bradAnders/kicad_PLEC/README.md

# kicad_PLEC
KiCad project for OSU USLI 2018 Payload Ejection Controller
