bradAnders/kicad_PLEC/PLEC_digikey_order1.xlsx

# | Quantity | Part Number | Manufacturer Part Number | Description | Customer Reference | Backorder | Unit Price | Extended Price
1 | 1 | 1568-1465-ND | DEV-14058 | TEENSY 3.6 (HEADERS) |  | 0 | 36.88 | 36.88
2 | 1 | 602-1346-ND | XBP9B-DMSTB002 | RF TXRX MODULE ISM<1GHZ RP-SMA |  | 0 | 42.76 | 42.76
3 | 1 | LM1085IT-5.0/NOPB-ND | LM1085IT-5.0/NOPB | IC REG LINEAR 5V 3A TO220-3 |  | 0 | 1.92 | 1.92
4 | 1 | LM1085IT-3.3/NOPB-ND | LM1085IT-3.3/NOPB | IC REG LINEAR 3.3V 3A TO220-3 |  | 0 | 1.92 | 1.92
5 | 1 | TLP222AF-ND | TLP222AF | PHOTOCOUPLER PHOTORELAY 4-DIP |  | 0 | 1.08 | 1.08
6 | 2 | TLP222A-2F-ND | TLP222A-2(F) | PHOTOCOUPLER PHOTORELAY 8-DIP |  | 0 | 2.16 | 4.32
7 | 5 | PB1167-ND | 1-1462039-5 | RELAY TELECOM DPDT 2A 3V |  | 0 | 4.43 | 22.15
8 | 1 | 398-1025-5-ND | HXS 20-NP | SENSOR CURRENT HALL 5A, 10A, 20A |  | 0 | 16.42 | 16.42
9 | 10 | 478-5094-ND | AR205F102K4R | CAP CER 1000PF 50V X8R RADIAL |  | 0 | 0.49 | 4.90
10 | 10 | 493-14716-ND | UEP1J4R7MED | CAP ALUM 4.7UF 20% 63V THRU HOLE |  | 0 | 0.455 | 4.55
11 | 10 | 493-14987-ND | UEP1J100MED | CAP ALUM 10UF 20% 63V RADIAL |  | 0 | 0.507 | 5.07
12 | 10 | CPF100KBCT-ND | CPF1100K00FEEE6 | RESISTOR METAL FILM 1W 100K OHM |  | 0 | 0.655 | 6.55
13 | 4 | CPF402BCT-ND | CPF1402R00FEEE6 | RESISTOR METAL FILM 1W 402 OHM |  | 0 | 0.79 | 3.16
14 | 2 | KSC2073H2TU-ND | KSC2073H2TU | TRANS NPN 150V 1.5A TO-220 |  | 0 | 0.64 | 1.28
15 | 4 | 754-1717-ND | WP424SRDT | LED RED DIFF 3MM ROUND T/H |  | 0 | 0.44 | 1.76
16 | 1 | CKN11096-ND | A102S1RNZQ | SWITCH ROTARY 2POS 2.5A 125V |  | 0 | 4.26 | 4.26
17 | 1 | J490-ND | 142-0701-401 | CONN SMA JACK STR 50 OHM SOLDER |  | 0 | 5.78 | 5.78
18 | 1 | CBA-SMA-SMA18-ND | CBA-SMA-SMA18 | CBL ASSY SMA M-SMA M REV 1800MM |  | 0 | 12.22 | 12.22
19 | 1 | ED10561-ND | OSTVN02A150 | CONN TERM BLOCK 2.54MM 2POS PCB |  | 0 | 0.91 | 0.91
20 | 1 | ED10562-ND | OSTVN03A150 | CONN TERM BLOCK 2.54MM 3POS PCB |  | 0 | 1.03 | 1.03
21 | 1 | ED10563-ND | OSTVN04A150 | CONN TERM BLOCK 2.54MM 4POS PCB |  | 0 | 1.38 | 1.38
22 | 1 | ED10565-ND | OSTVN06A150 | CONN TERM BLOCK 2.54MM 6POS PCB |  | 0 | 1.77 | 1.77
23 | 3 | WM18900-ND | 22-05-7025 | CONN HEADER 2POS 2.5MM R/A TIN |  | 0 | 0.59 | 1.77
24 | 3 | WM18873-ND | 0050375023 | CONN HOUSING 2POS 2.5MM SHROUD |  | 0 | 0.21 | 0.63
25 | 2 | 1N5619GP-E3/54GICT-ND | 1N5619GP-E3/54 | DIODE GEN PURP 600V 1A DO204AC |  | 0 | 0.41 | 0.82
