bradAnders/kicad_PLEC/PLEC.sch

## KiCad design PLEC.sch (2018-02-16)

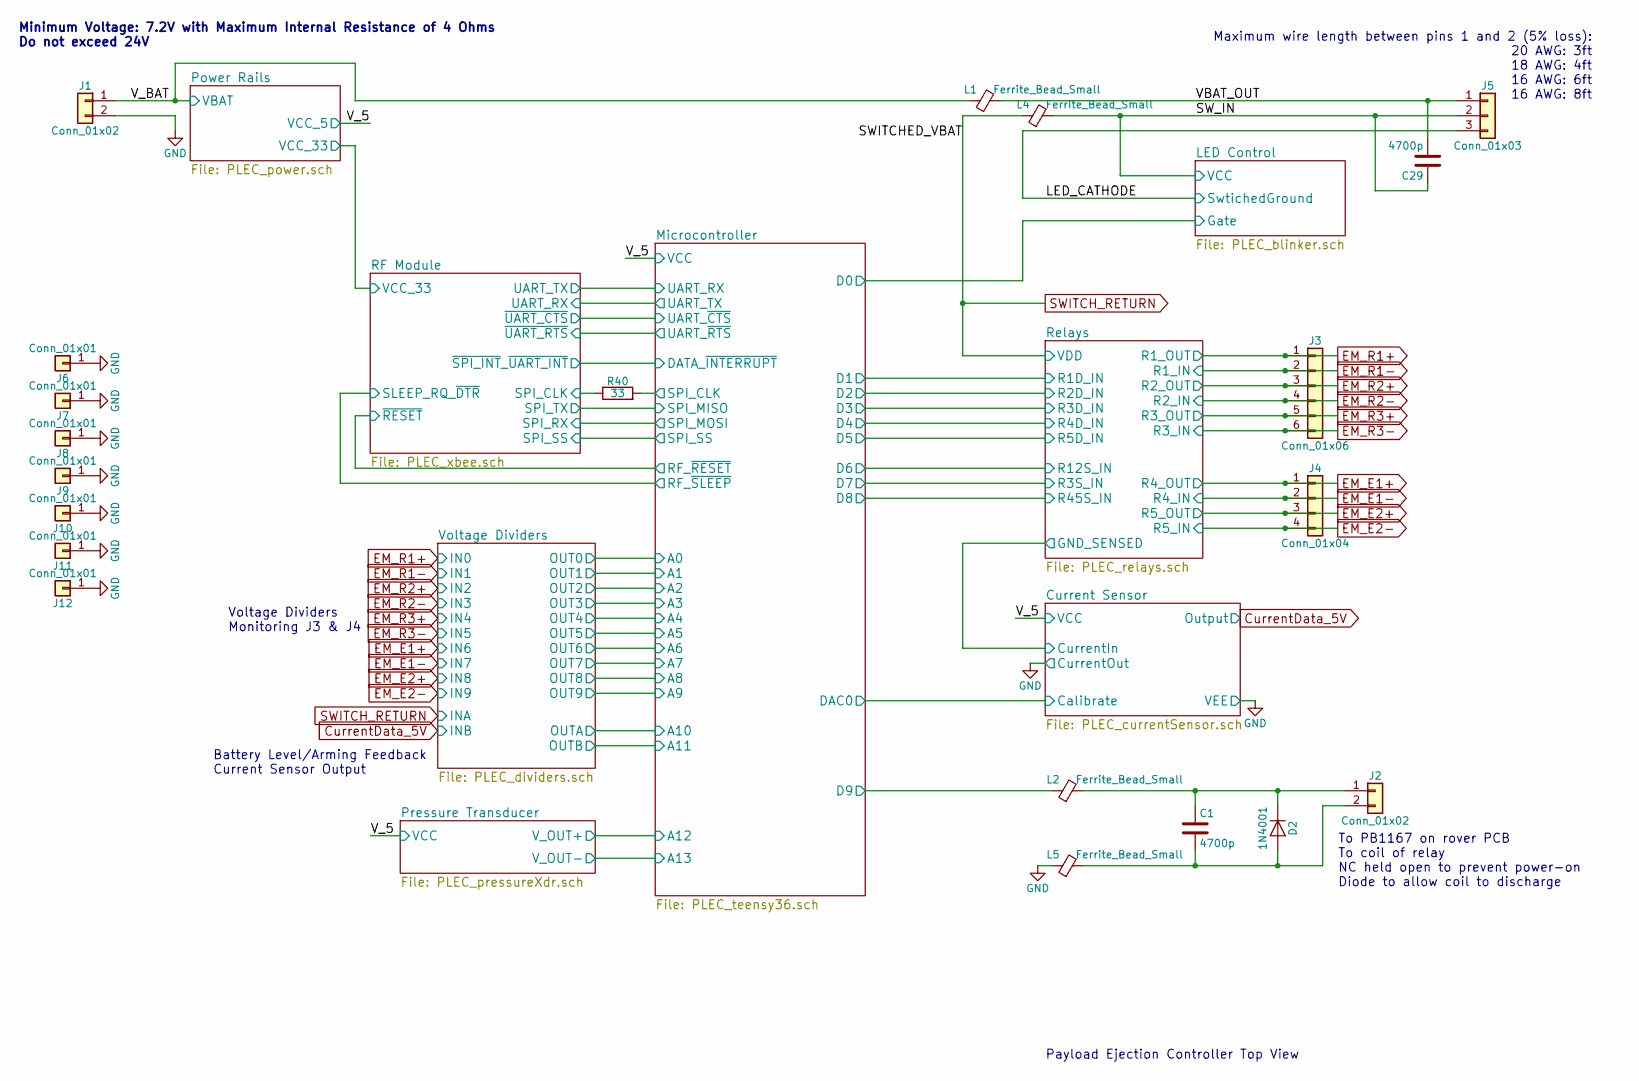
[picture p1: schematic PLEC.sch]

Parts:
C1, C29: 4700p; THTt_100Px150Lx100Wx183H_4700p
D2: 1N4001; D_DO-41_SOD81_P2.54mm_Vertical_KathodeUp
J1: Conn_01x02; TerminalBlock_Altech_AK300-2_P5.00mm
J2: Conn_01x02; THT_TerminalBlock_2.5mm_2pos
J3: Conn_01x06; THT_TerminalBlock_2.5mm_6pos
J4: Conn_01x04; THT_TerminalBlock_2.5mm_4pos
J5: Conn_01x03; THT_TerminalBlock_2.5mm_3pos
J6, J7, J8, J9, J10, J11: Conn_01x01; Hole4-40
J12: Conn_01x01; Via-0.6mm
L1, L2, L4, L5: Ferrite_Bead_Small; L_Axial_L7.0mm_D3.3mm_P5.08mm_Vertical_Fastron_MICC
R40: 33; R_Axial_DIN0204_L3.6mm_D1.6mm_P5.08mm_Horizontal

Connections:
D9: L2.1
EM_E1+: J4.1
EM_E1-: J4.2
EM_E2+: J4.3
EM_E2-: J4.4
EM_R1+: J3.1
EM_R1-: J3.2
EM_R2+: J3.3
EM_R2-: J3.4
EM_R3+: J3.5
EM_R3-: J3.6
GND: J1.2, J6.1, J7.1, J8.1, J9.1, J10.1, J11.1, J12.1, L5.1
LED_CATHODE: J5.3
unnamed: C1.1, D2.1 (K), J2.1, L2.2
unnamed: C1.2, D2.2 (A), J2.2, L5.2
SPI_CLK: R40.1, R40.2
SWITCH_RETURN: L4.1
SW_IN: C29.1, J5.2, L4.2
VBAT_OUT: C29.2, J5.1, L1.2
V_BAT: J1.1, L1.1

Notes on the sheet:
Payload Ejection Controller Top View
Minimum Voltage: 7.2V with Maximum Internal Resistance of 4 Ohms Do not exceed 24V
Maximum wire length between pins 1 and 2 (5% loss): 20 AWG: 3ft 18 AWG: 4ft 16 AWG: 6ft 16 AWG: 8ft
Voltage Dividers Monitoring J3 & J4
Battery Level/Arming Feedback Current Sensor Output
To PB1167 on rover PCB To coil of relay NC held open to prevent power-on Diode to allow coil to discharge
