bradAnders/kicad_PLEC/PLEC_blinker.sch

## KiCad design PLEC_blinker.sch (2018-02-16)

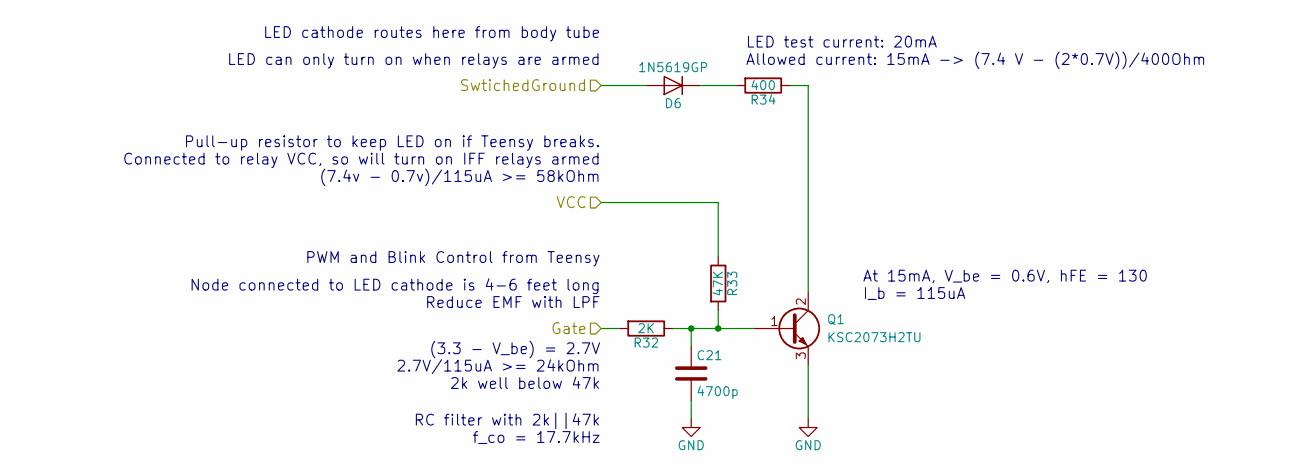
[picture p2: schematic PLEC_blinker.sch]

Parts:
C21: 4700p; THTt_100Px150Lx100Wx183H_4700p
D6: 1N5619GP; D_DO-41_SOD81_P2.54mm_Vertical_KathodeUp
Q1: KSC2073H2TU; TO-220-3_Vertical
R32: 2K; R_Axial_DIN0204_L3.6mm_D1.6mm_P5.08mm_Horizontal
R33: 47K; R_Axial_DIN0204_L3.6mm_D1.6mm_P5.08mm_Horizontal
R34: 400; R_Axial_DIN0207_L6.3mm_D2.5mm_P10.16mm_Horizontal

Connections:
GND: C21.2, Q1.3 (E)
Gate: R32.2
unnamed: C21.1, Q1.1 (B), R32.1, R33.2
unnamed: D6.1 (K), R34.2
unnamed: Q1.2 (C), R34.1
SwtichedGround: D6.2 (A)
VCC: R33.1

Notes on the sheet:
LED can only turn on when relays are armed
PWM and Blink Control from Teensy
Node connected to LED cathode is 4-6 feet long Reduce EMF with LPF
LED cathode routes here from body tube
Pull-up resistor to keep LED on if Teensy breaks. Connected to relay VCC, so will turn on IFF relays armed (7.4v - 0.7v)/115uA >= 58kOhm
LED test current: 20mA Allowed current: 15mA -> (7.4 V - (2*0.7V))/400Ohm
At 15mA, V_be = 0.6V, hFE = 130 I_b = 115uA
(3.3 - V_be) = 2.7V 2.7V/115uA >= 24kOhm 2k well below 47k
RC filter with 2k||47k f_co = 17.7kHz
