bradAnders/kicad_PLEC/PLEC_currentSensor.sch

## KiCad design PLEC_currentSensor.sch (2018-02-14)

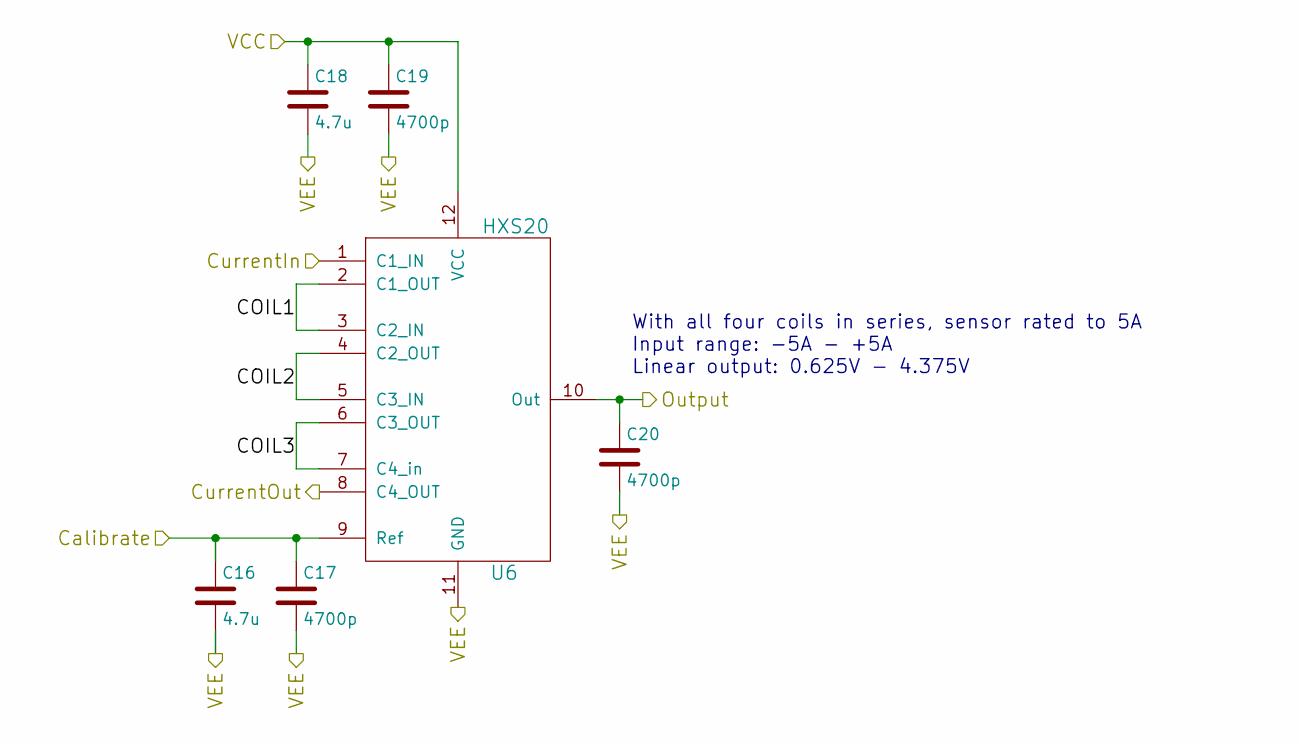
[picture p3: schematic PLEC_currentSensor.sch]

Parts:
C16, C18: 4.7u; THTm_1.5Px4Dx7H_4.7u
C17, C19, C20: 4700p; THTt_100Px150Lx100Wx183H_4700p
U6: HXS20

Connections:
COIL1: U6.2 (C1_OUT), U6.3 (C2_IN)
COIL2: U6.4 (C2_OUT), U6.5 (C3_IN)
COIL3: U6.6 (C3_OUT), U6.7 (C4_in)
Calibrate: C16.1, C17.1, U6.9 (Ref)
CurrentIn: U6.1 (C1_IN)
CurrentOut: U6.8 (C4_OUT)
Output: C20.1, U6.10 (Out)
VCC: C18.1, C19.1, U6.12 (VCC)
VEE: C16.2, C17.2, C18.2, C19.2, C20.2, U6.11 (GND)

Notes on the sheet:
With all four coils in series, sensor rated to 5A Input range: -5A - +5A Linear output: 0.625V - 4.375V
