bradAnders/kicad_PLEC/PLEC_dividers.sch

## KiCad design PLEC_dividers.sch (2018-02-16)

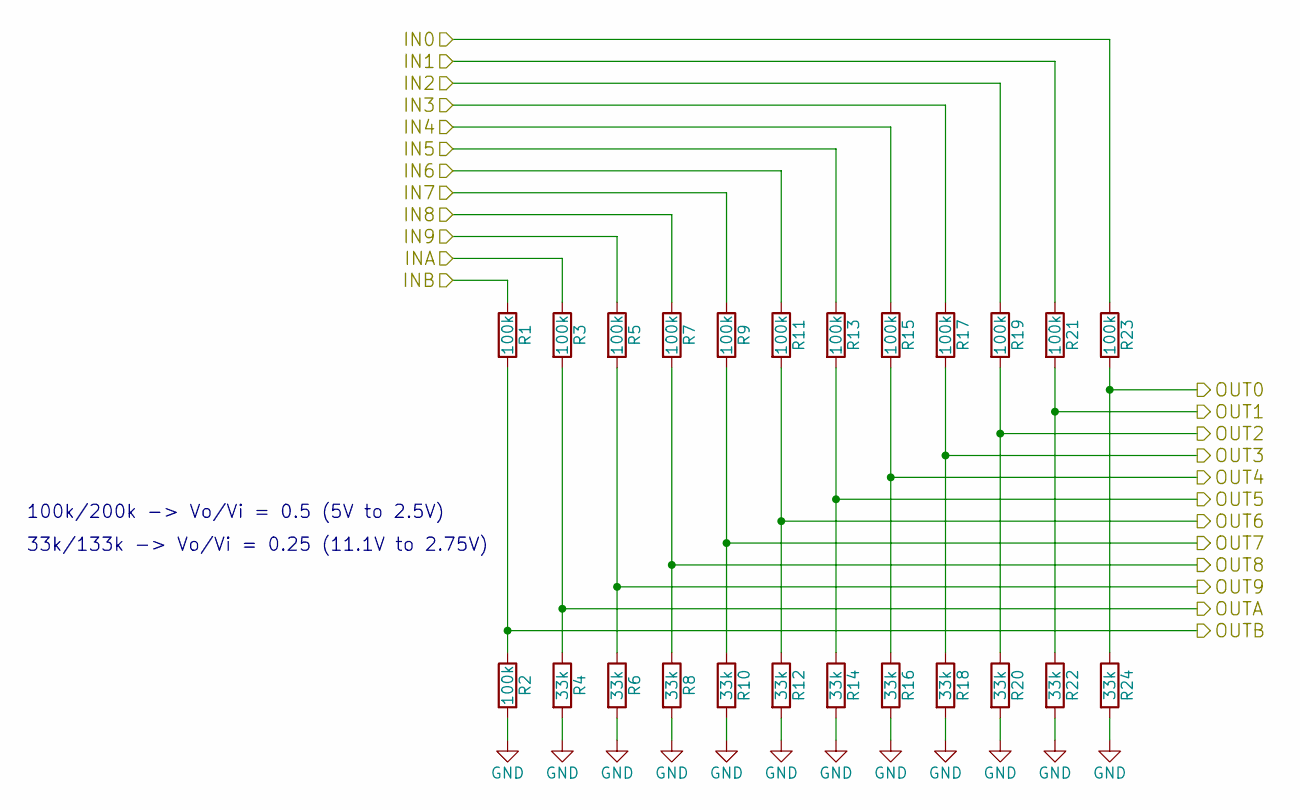
[picture p4: schematic PLEC_dividers.sch]

Parts:
R1, R2, R3, R5, R7, R9, R11, R13, R15, R17, R19, R21, R23: 100k; R_Axial_DIN0204_L3.6mm_D1.6mm_P5.08mm_Horizontal
R4, R6, R8, R10, R12, R14, R16, R18, R20, R22, R24: 33k; R_Axial_DIN0204_L3.6mm_D1.6mm_P5.08mm_Horizontal

Connections:
GND: R2.2, R4.2, R6.2, R8.2, R10.2, R12.2, R14.2, R16.2, R18.2, R20.2, R22.2, R24.2
IN0: R23.1
IN1: R21.1
IN2: R19.1
IN3: R17.1
IN4: R15.1
IN5: R13.1
IN6: R11.1
IN7: R9.1
IN8: R7.1
IN9: R5.1
INA: R3.1
INB: R1.1
OUT0: R23.2, R24.1
OUT1: R21.2, R22.1
OUT2: R19.2, R20.1
OUT3: R17.2, R18.1
OUT4: R15.2, R16.1
OUT5: R13.2, R14.1
OUT6: R11.2, R12.1
OUT7: R9.2, R10.1
OUT8: R7.2, R8.1
OUT9: R5.2, R6.1
OUTA: R3.2, R4.1
OUTB: R1.2, R2.1

Notes on the sheet:
100k/200k -> Vo/Vi = 0.5 (5V to 2.5V)
33k/133k -> Vo/Vi = 0.25 (11.1V to 2.75V)
