bradAnders/kicad_PLEC/PLEC_power.sch

## KiCad design PLEC_power.sch (2018-02-16)

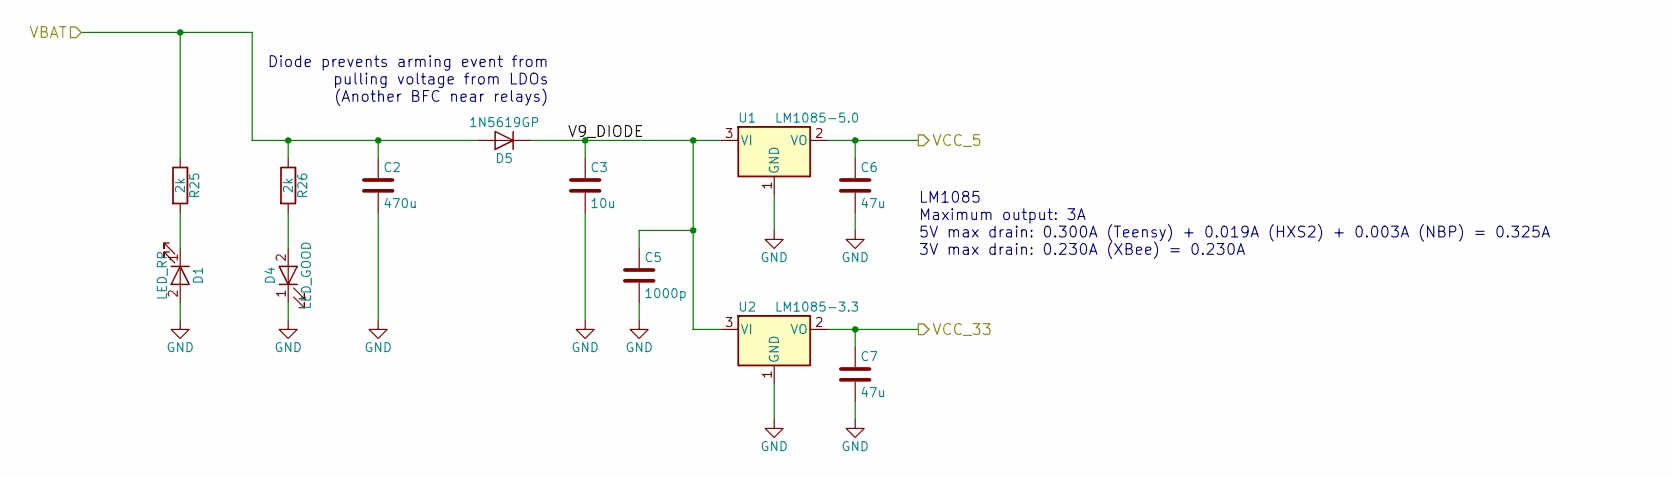
[picture p5: schematic PLEC_power.sch]

Parts:
C2: 470u; THTm_5Px8Dx22H__470u
C3: 10u; THTm_1.5Px4Dx7H_10u
C5: 1000p; THTt_100Px200Lx125Wx200H_1000p
C6, C7: 47u; THTm_2Px4Dx12H_47u
D1: LED_RP; LED_D3.0mm_FlatTop
D4: LED_GOOD; LED_D5.0mm_FlatTop
D5: 1N5619GP; D_DO-15_P10.16mm_Horizontal
R25, R26: 2k; R_Axial_DIN0204_L3.6mm_D1.6mm_P5.08mm_Horizontal
U1: LM1085-5.0; TO-220-3_Vertical
U2: LM1085-3.3; TO-220-3_Vertical

Connections:
GND: C2.2, C3.2, C5.2, C6.2, C7.2, D1.2 (A), D4.1 (K), U1.1 (GND), U2.1 (GND)
unnamed: D1.1 (K), R25.2
unnamed: D4.2 (A), R26.2
V9_DIODE: C3.1, C5.1, D5.1 (K), U1.3 (VI), U2.3 (VI)
VBAT: C2.1, D5.2 (A), R25.1, R26.1
VCC_5: C6.1, U1.2 (VO)
VCC_33: C7.1, U2.2 (VO)

Notes on the sheet:
Diode prevents arming event from pulling voltage from LDOs (Another BFC near relays)
LM1085 Maximum output: 3A 5V max drain: 0.300A (Teensy) + 0.019A (HXS2) + 0.003A (NBP) = 0.325A 3V max drain: 0.230A (XBee) = 0.230A
