bradAnders/kicad_PLEC/PLEC_pressureXdr.sch

## KiCad design PLEC_pressureXdr.sch (2018-02-16)

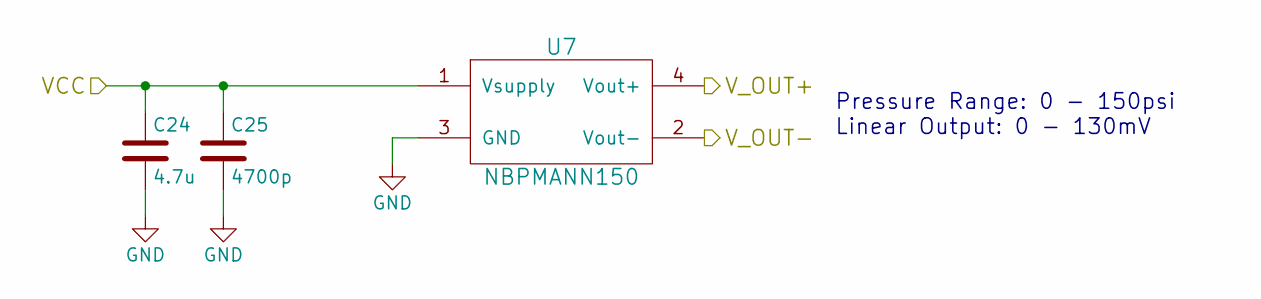
[picture p6: schematic PLEC_pressureXdr.sch]

Parts:
C24: 4.7u; THTm_1.5Px4Dx7H_4.7u
C25: 4700p; THTt_100Px150Lx100Wx183H_4700p
U7: NBPMANN150; NBPMANN

Connections:
GND: C24.2, C25.2, U7.3 (GND)
VCC: C24.1, C25.1, U7.1 (Vsupply)
V_OUT+: U7.4 (Vout+)
V_OUT-: U7.2 (Vout-)

Notes on the sheet:
Pressure Range: 0 - 150psi Linear Output: 0 - 130mV
