bradAnders/kicad_PLEC/PLEC_relays.sch

## KiCad design PLEC_relays.sch (2018-02-16)

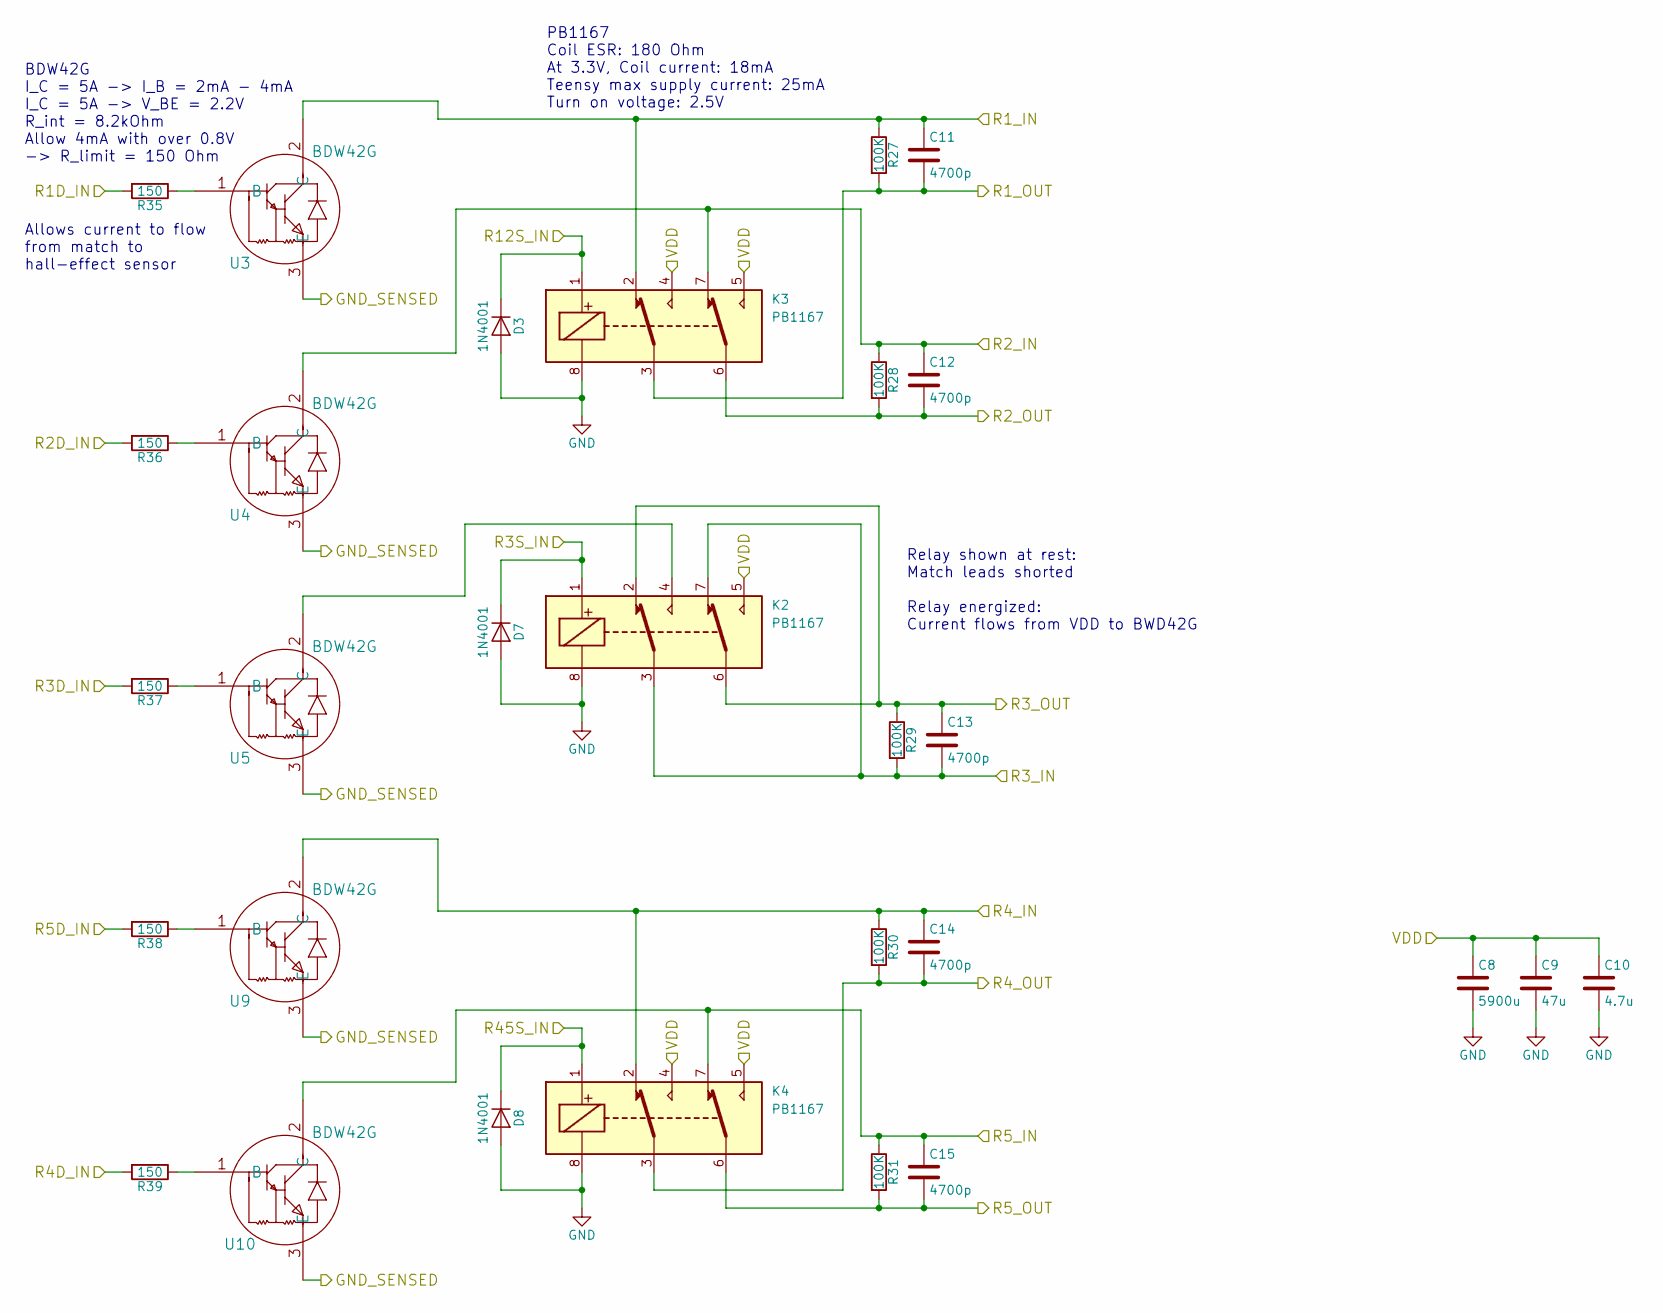
[picture p7: schematic PLEC_relays.sch]

Parts:
C8: 5900u; ELBK250
C9: 47u; THTm_2Px4Dx12H_47u
C10: 4.7u; THTm_1.5Px4Dx7H_4.7u
C11, C12, C13, C14, C15: 4700p; THTt_100Px150Lx100Wx183H_4700p
D3, D7, D8: 1N4001; D_DO-41_SOD81_P2.54mm_Vertical_KathodeUp
K2, K3, K4: PB1167
R27, R28, R29, R30, R31: 100K; R_Axial_DIN0204_L3.6mm_D1.6mm_P5.08mm_Horizontal
R35, R36, R37, R38, R39: 150; R_Axial_DIN0204_L3.6mm_D1.6mm_P5.08mm_Horizontal
U3, U4, U5, U9, U10: BDW42G

Connections:
GND: C8.2, C9.2, C10.2, D3.2 (A), D7.2 (A), D8.2 (A), K2.8, K3.8, K4.8
GND_SENSED: U3.3 (E), U4.3 (E), U5.3 (E), U9.3 (E), U10.3 (E)
unnamed: K2.4, U5.2 (C)
unnamed: R35.1, U3.1 (B)
unnamed: R36.1, U4.1 (B)
unnamed: R37.1, U5.1 (B)
unnamed: R38.1, U9.1 (B)
unnamed: R39.1, U10.1 (B)
R1D_IN: R35.2
R1_IN: C11.1, K3.2, R27.1, U3.2 (C)
R1_OUT: C11.2, K3.3, R27.2
R2D_IN: R36.2
R2_IN: C12.1, K3.7, R28.1, U4.2 (C)
R2_OUT: C12.2, K3.6, R28.2
R3D_IN: R37.2
R3S_IN: D7.1 (K), K2.1
R3_IN: C13.2, K2.3, K2.7, R29.2
R3_OUT: C13.1, K2.2, K2.6, R29.1
R4D_IN: R39.2
R4_IN: C14.1, K4.2, R30.1, U9.2 (C)
R4_OUT: C14.2, K4.3, R30.2
R5D_IN: R38.2
R5_IN: C15.1, K4.7, R31.1, U10.2 (C)
R5_OUT: C15.2, K4.6, R31.2
R12S_IN: D3.1 (K), K3.1
R45S_IN: D8.1 (K), K4.1
VDD: C8.1, C9.1, C10.1, K2.5, K3.4, K3.5, K4.4, K4.5

Notes on the sheet:
PB1167 Coil ESR: 180 Ohm At 3.3V, Coil current: 18mA Teensy max supply current: 25mA Turn on voltage: 2.5V
BDW42G I_C = 5A -> I_B = 2mA - 4mA I_C = 5A -> V_BE = 2.2V R_int = 8.2kOhm Allow 4mA with over 0.8V -> R_limit = 150 Ohm
Relay shown at rest: Match leads shorted Relay energized: Current flows from VDD to BWD42G
Allows current to flow from match to hall-effect sensor
