bradAnders/kicad_PLEC/PLEC_teensy36.sch

## KiCad design PLEC_teensy36.sch (2018-02-16)

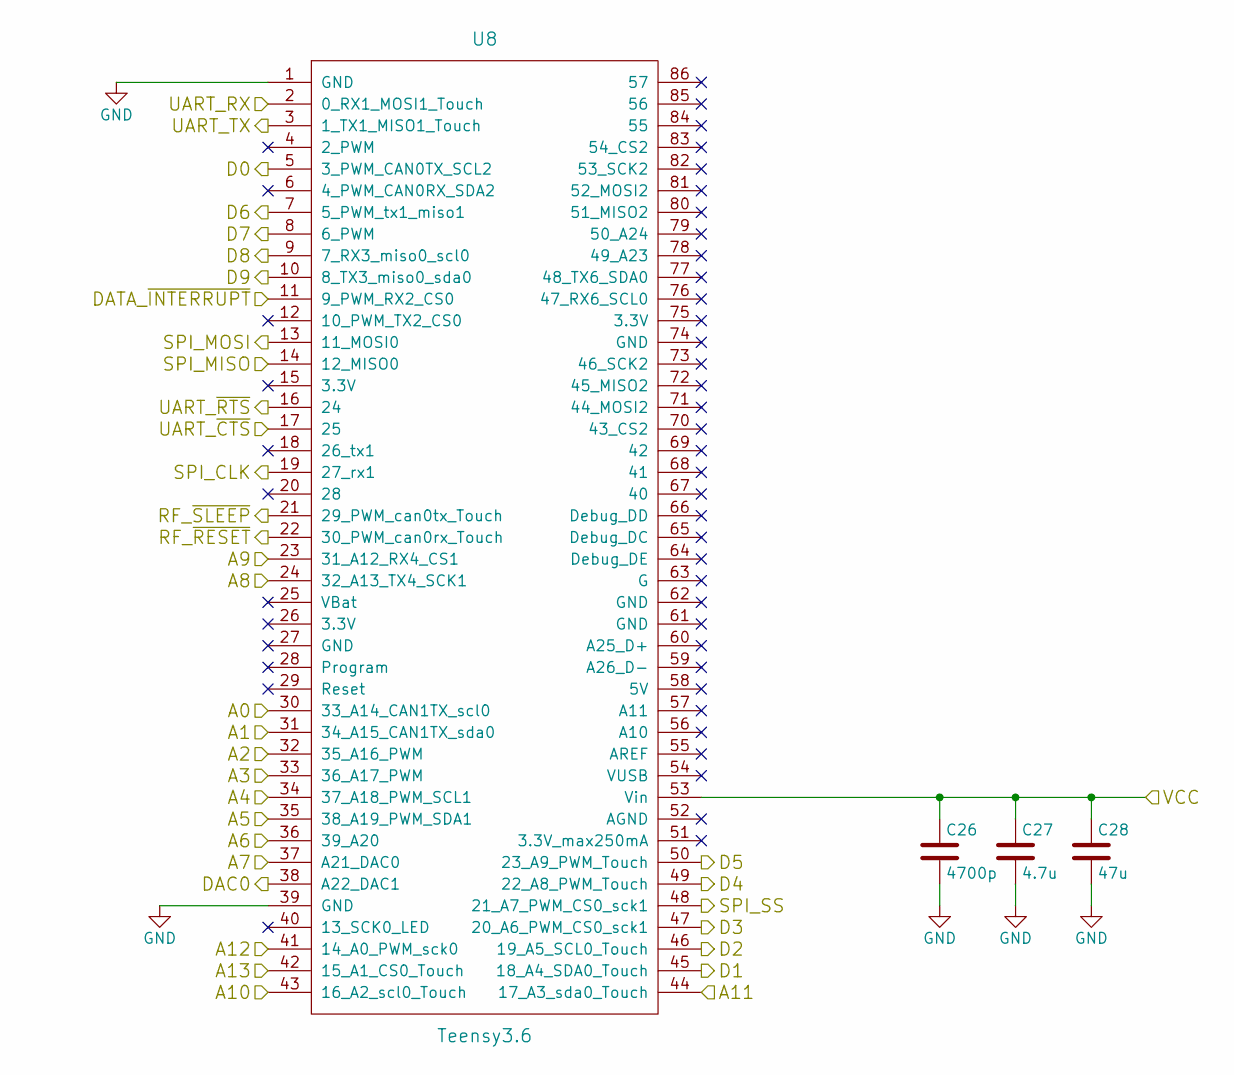
[picture p8: schematic PLEC_teensy36.sch]

Parts:
C26: 4700p; THTt_100Px150Lx100Wx183H_4700p
C27: 4.7u; THTm_1.5Px4Dx7H_4.7u
C28: 47u; THTm_2Px4Dx12H_47u
U8: Teensy3.6; teensy3.6

Connections:
A0: U8.30 (33_A14_CAN1TX_scl0)
A1: U8.31 (34_A15_CAN1TX_sda0)
A2: U8.32 (35_A16_PWM)
A3: U8.33 (36_A17_PWM)
A4: U8.34 (37_A18_PWM_SCL1)
A5: U8.35 (38_A19_PWM_SDA1)
A6: U8.36 (39_A20)
A7: U8.37 (A21_DAC0)
A8: U8.24 (32_A13_TX4_SCK1)
A9: U8.23 (31_A12_RX4_CS1)
A10: U8.43 (16_A2_scl0_Touch)
A11: U8.44 (17_A3_sda0_Touch)
A12: U8.41 (14_A0_PWM_sck0)
A13: U8.42 (15_A1_CS0_Touch)
D0: U8.5 (3_PWM_CAN0TX_SCL2)
D1: U8.45 (18_A4_SDA0_Touch)
D2: U8.46 (19_A5_SCL0_Touch)
D3: U8.47 (20_A6_PWM_CS0_sck1)
D4: U8.49 (22_A8_PWM_Touch)
D5: U8.50 (23_A9_PWM_Touch)
D6: U8.7 (5_PWM_tx1_miso1)
D7: U8.8 (6_PWM)
D8: U8.9 (7_RX3_miso0_scl0)
D9: U8.10 (8_TX3_miso0_sda0)
DAC0: U8.38 (A22_DAC1)
DATA_~INTERRUPT: U8.11 (9_PWM_RX2_CS0)
GND: C26.2, C27.2, C28.2, U8.1 (GND), U8.39 (GND)
RF_~RESET: U8.22 (30_PWM_can0rx_Touch)
RF_~SLEEP: U8.21 (29_PWM_can0tx_Touch)
SPI_CLK: U8.19 (27_rx1)
SPI_MISO: U8.14 (12_MISO0)
SPI_MOSI: U8.13 (11_MOSI0)
SPI_SS: U8.48 (21_A7_PWM_CS0_sck1)
UART_RX: U8.2 (0_RX1_MOSI1_Touch)
UART_TX: U8.3 (1_TX1_MISO1_Touch)
UART_~CTS: U8.17 (25)
UART_~RTS: U8.16 (24)
VCC: C26.1, C27.1, C28.1, U8.53 (Vin)
