bradAnders/kicad_PLEC/PLEC_xbee.sch

## KiCad design PLEC_xbee.sch (2018-02-16)

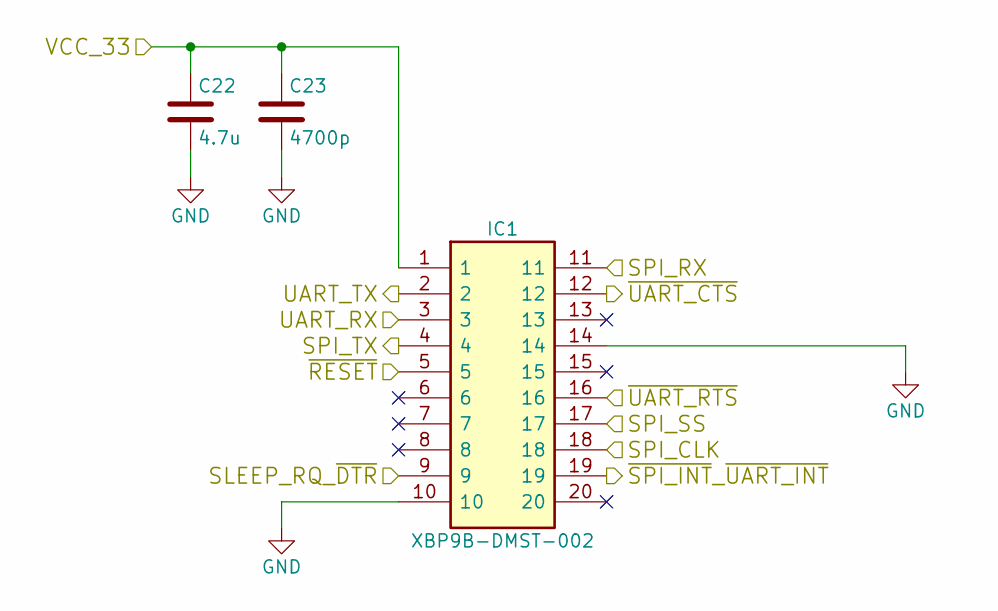
[picture p9: schematic PLEC_xbee.sch]

Parts:
C22: 4.7u; THTm_1.5Px4Dx7H_4.7u
C23: 4700p; THTt_100Px150Lx100Wx183H_4700p
IC1: XBP9B-DMST-002; Manufacturer_Part_Number XBP9B-DMST-002

Connections:
GND: C22.2, C23.2, IC1.10, IC1.14
SLEEP_RQ_~DTR: IC1.9
SPI_CLK: IC1.18
SPI_RX: IC1.11
SPI_SS: IC1.17
SPI_TX: IC1.4
UART_RX: IC1.3
UART_TX: IC1.2
VCC_33: C22.1, C23.1, IC1.1
~RESET: IC1.5
~SPI_INT~_~UART_INT: IC1.19
~UART_CTS: IC1.12
~UART_RTS: IC1.16
