bradAnders/kicad_PLEC/(commit log)

2018-02-07 Almost done with layout; need to rearrange uC pins
    [PLEC.kicad_pcb, PLEC.sch, PLEC_blinker.sch, PLEC_currentSensor.sch, PLEC_power.sch, PLEC_pressureXdr.sch, PLEC_relays.sch, PLEC_teensy36.sch]
2018-02-08 Finished PCB with no errors
    [PLEC.kicad_pcb, PLEC.sch, PLEC_currentSensor.sch, PLEC_power.sch, PLEC_relays.sch, PLEC_teensy36.sch]
2018-02-08 Added logo and schematic PDF
    [PLEC.sch]
2018-02-14 Replaced solid state relays with NPN Darlingtons
    [PLEC.kicad_pcb, PLEC.sch, PLEC_blinker.sch, PLEC_currentSensor.sch, PLEC_dividers.sch, PLEC_power.sch, PLEC_pressureXdr.sch, PLEC_relays.sch]
2018-02-16 Stiched vias and added mounting holes with no errors
    [PLEC.csv, PLEC.kicad_pcb, PLEC.sch, PLEC_blinker.sch, PLEC_dividers.sch, PLEC_power.sch, PLEC_pressureXdr.sch, PLEC_relays.sch]
